Dev-Code-Vault/ELEE4230E_Sensors/README.md

# ELEE4230E_Sensors

## Rotating Pendulum Stability Sensor Platform

This project is a battery-powered rotating pendulum sensing platform for ELEE 4230 Sensors and Transducers. The system measures pendulum stability using a raw Hall effect sensor, an MPU6050 IMU, and an INA219 current sensor.
