Dev-Code-Vault/ELEE4230E_Sensors/notes/design_decisions.md

# Design Decisions

## CP1

- Selected A1302 Hall Effect sensor as RAW sensor.
- Selected MPU6050 as first pre-packaged sensor.
- Selected INA219 as second pre-packaged sensor.
- Replaced BME280 with INA219 after motor was added to the design.
