Dev-Code-Vault/ELEE4230E_Sensors/media/plots/Cp2_transfer_function_etc.png

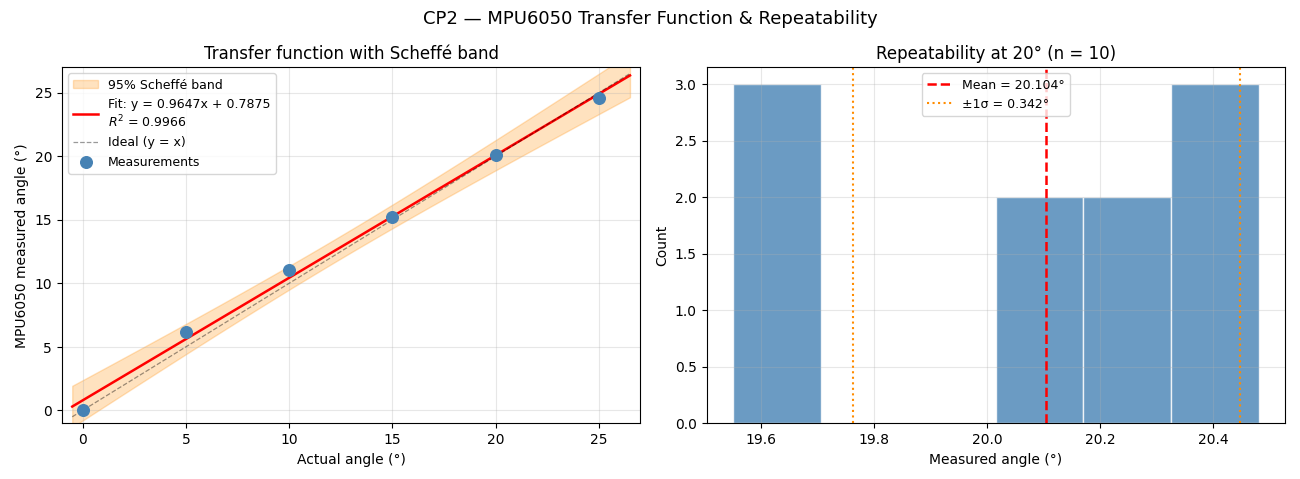
media/plots/Cp2_transfer_function_etc.png
