Dev-Code-Vault/ELEE4230E_Sensors/media/plots/IOT_thing_speak_angle_logger.png

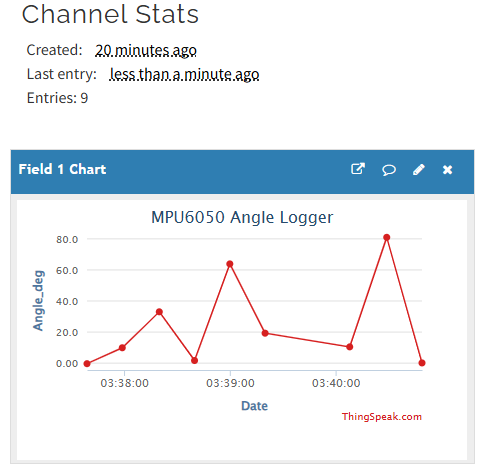
media/plots/IOT_thing_speak_angle_logger.png
