Dev-Code-Vault/ELEE4230E_Sensors/media/plots/kalman_plot.png

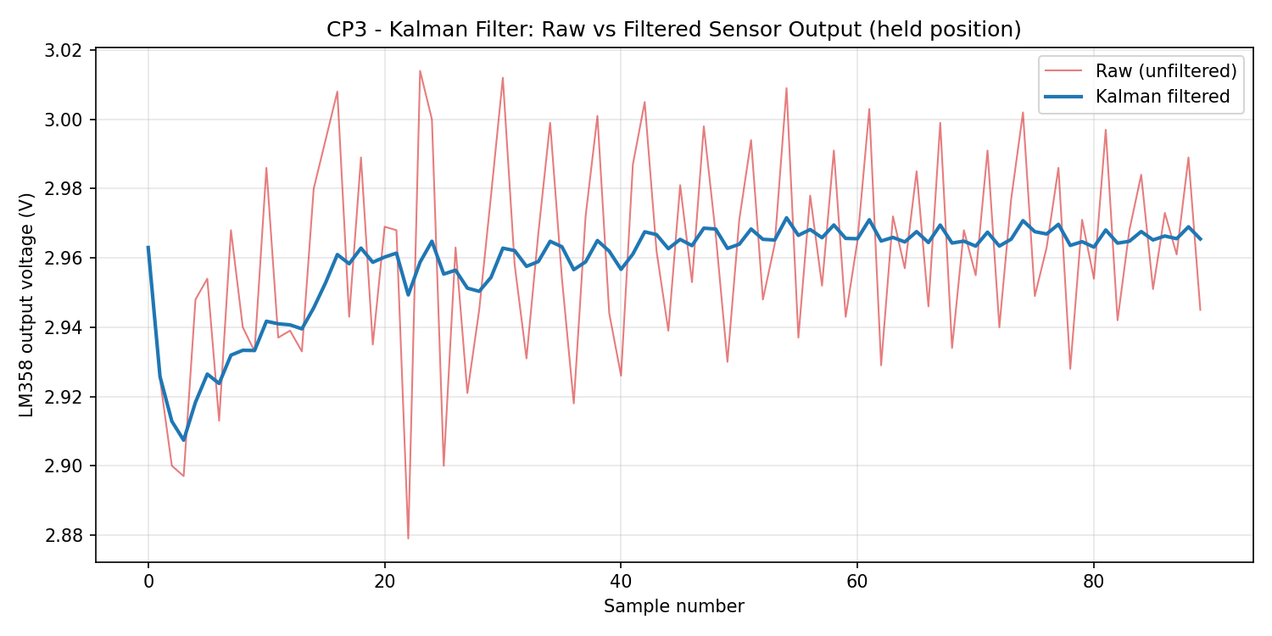
media/plots/kalman_plot.png
