Dev-Code-Vault/ELEE4230E_Sensors/firmware/mpu6050_serial_csv/mpu6050_serial_csv.ino

//mpu6050_serial_csv.ino

#include <Wire.h>
#include <Adafruit_MPU6050.h>
#include <Adafruit_Sensor.h>

Adafruit_MPU6050 mpu;

void setup() {
  Serial.begin(115200);
  delay(1000);

  Wire.begin(21, 22); // SDA, SCL for ESP32

  if (!mpu.begin()) {
    Serial.println("MPU6050 not found");
    while (1) delay(10);
  }

  Serial.println("time_ms,accel_x,accel_y,accel_z,gyro_x,gyro_y,gyro_z,angle_deg");
}

void loop() {
  sensors_event_t a, g, temp;
  mpu.getEvent(&a, &g, &temp);

  float angle_deg = atan2(a.acceleration.y, a.acceleration.z) * 180.0 / PI;

  Serial.print(millis());
  Serial.print(",");
  Serial.print(a.acceleration.x);
  Serial.print(",");
  Serial.print(a.acceleration.y);
  Serial.print(",");
  Serial.print(a.acceleration.z);
  Serial.print(",");
  Serial.print(g.gyro.x);
  Serial.print(",");
  Serial.print(g.gyro.y);
  Serial.print(",");
  Serial.print(g.gyro.z);
  Serial.print(",");
  Serial.println(angle_deg);

  delay(100);
}
