Dev-Code-Vault/ELEE4230E_Sensors/firmware/i2c_scanner/i2c_scanner.ino

#include <Wire.h>

void setup() {
  Wire.begin(21, 22);
  Serial.begin(115200);
  delay(1000);
  Serial.println("Scanning...");
}

void loop() {
  byte error, address;
  int nDevices = 0;

  for (address = 1; address < 127; address++) {
    Wire.beginTransmission(address);
    error = Wire.endTransmission();

    if (error == 0) {
      Serial.print("I2C device found at 0x");
      if (address < 16) Serial.print("0");
      Serial.println(address, HEX);
      nDevices++;
    }
  }

  if (nDevices == 0) {
    Serial.println("No devices found");
  }

  Serial.println("Scan complete.");
  delay(5000);
}
