Dev-Code-Vault/ELEE4230E_Sensors/(commit log)

2026-06-23 Add MPU6050 serial logging and CP2 analysis
    [imu_calibration.csv]
2026-06-23 Verify ESP32 upload and serial output
2026-06-23 Add I2C scanner for MPU6050 detection
2026-06-23 Calibration and all scripts updated to reflect current code
    [imu_calibration.csv]
2026-06-30 all files for CP3
    [a1302_calibration.csv]
